jusii/ninepin-ux/hardware/rev7.1/fab/ninepin-ux-rev7.1-full-bom.csv

Comment | Designator | Footprint | LCSC Part #
22uF | C1 | C_0805_2012Metric | C45783
10uF | C2,C6,C10,C14 | C_0805_2012Metric | C15850
100nF | C3,C5,C7,C11,C12,C13,C23,C24,C26,C27,C28,C32,C36 | C_0603_1608Metric | C14663
150uF | C4 | CP_Elec_6.3x7.7 | C413656
1uF | C8,C9,C31 | C_0603_1608Metric | C15849
4.7uF | C20,C29,C38 | C_0402_1005Metric | C23733
100nF | C21,C22,C25,C30,C39,C40 | C_0402_1005Metric | C1525
15pF | C33,C34 | C_0603_1608Metric | C1644
4.7uF | C35 | C_0805_2012Metric | C1779
4.7uF | C37 | C_0603_1608Metric | C19666
SS34 | D1,D2,D3 | D_SMA | C8678
B5819W | D4,D5,D6 | D_SOD-123 | C8598
PESD5V0S1BA | D10,D11,D12,D20,D21,D22,D23,D24,D25,D26,D27,D28,D29,D30 | D_SOD-323 | C19224
PESD5V0S1BL | D13,D14,D15,D16,D17,D18,D19 | D_SOD-882 | C84374
750mA | F1 | Fuse_1812_4532Metric | C84140
500mA | F2,F3 | Fuse_1812_4532Metric | C17313
600R@100MHz | FB1 | L_0603_1608Metric | C19330
A500 KBD OUT | J1,J8 | PinHeader_1x08_P2.54mm_Vertical | C492407
SWD | J2 | PinHeader_1x03_P2.54mm_Vertical | C2937625
OLED | J3 | PinSocket_1x04_P2.54mm_Vertical | C2897367
USB-A HOST | J4 | USB_A_Molex_67643_Horizontal | C564920
ENCODER | J7 | PinHeader_2x03_P2.54mm_Vertical | C65114
KBD OUT (to Amiga) | J10,J12 | MiniDIN6_PS2_Socket_CUI_MD-60S | C6089346
USB-C | J13 | USB_C_Receptacle_GCT_USB4105-xx-A_16P_TopMnt_Horizontal | C5184243
3.3uH | L1 | L_2016_AOTA | C42411119
WS2812B-2020 | LED1 | LED_WS2812B-2020_PLCC4_2.0x2.0mm | C52917434
DE9 PORT 1 | P1,P2 | DSUB-9_Pins_Horizontal_P2.77x2.84mm_EdgePinOffset7.70mm_Housed_MountingHolesOffset9.12mm | C305939
2N7002 | Q1 | SOT-23 | C8545
BSS138 | Q2,Q3 | SOT-23 | C82045
4.7k | R41,R42,R68 | R_0603_1608Metric | C23162
5.1k | R43,R44 | R_0603_1608Metric | C23186
470 | R45,R55 | R_0603_1608Metric | C23179
100k | R46,R47 | R_0603_1608Metric | C25803
1k | R49,R52,R53,R54,R60 | R_0603_1608Metric | C21190
33 | R50,R59 | R_0603_1608Metric | C23140
10k | R56,R69 | R_0603_1608Metric | C25804
27 | R57,R58,R70,R71 | R_0603_1608Metric | C25190
10k | R61,R62,R63,R64,R65,R66,R67 | R_0402_1005Metric | C25744
15k | R72,R73 | R_0402_1005Metric | C25756
4x10k | RN1,RN2,RN4 | R_Array_Convex_4x0402 | C25725
4x10k | RN3 | R_Array_Convex_4x0603 | C29718
BOOT | SW1,SW2 | SW_Tactile_SPST_Angled_PTS645Vx58-2LFS | C285519
RP2350A | U1 | QFN-60-1EP_7x7mm_P0.4mm_EP3.4x3.4mm | C42411118
USBLC6-2SC6 | U2,U4 | SOT-23-6 | C7519
TLV75733PDRVR | U3 | WSON-6-1EP_2x2mm_P0.65mm_EP1x1.6mm | C2868428
SN74CBTD3861DBQR | U6,U7 | SSOP-24_3.9x8.7mm_P0.635mm | C44508
W25Q128JVSIQ | U8 | SOIC-8_5.3x5.3mm_P1.27mm | C97521
RM2 | U9 | RaspberryPi_RM2 | C49451547
TCA9554PWR | U10 | TSSOP-16_4.4x5mm_P0.65mm | C477924
TLV803SDBZR | U11 | SOT-23 | C132016
12MHz | Y1 | Crystal_SMD_3225-4Pin_3.2x2.5mm | C20625731
