jusii/ninepin-ux/hardware/case/ninepin-ux-case-tray.stl

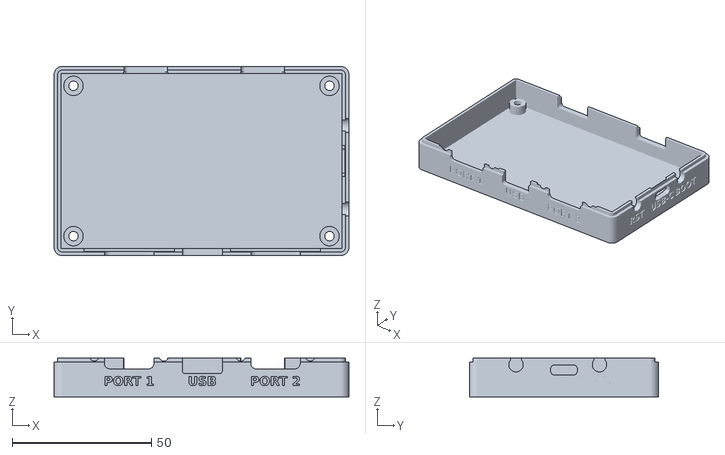
[picture p2: CAD file, 2026-11-13]
hardware/case/ninepin-ux-case-tray.stl
106.0 x 68.0 x 14.0
