jusii/ninepin-ux/hardware/case/ninepin-ux-case-tray-labels.stl

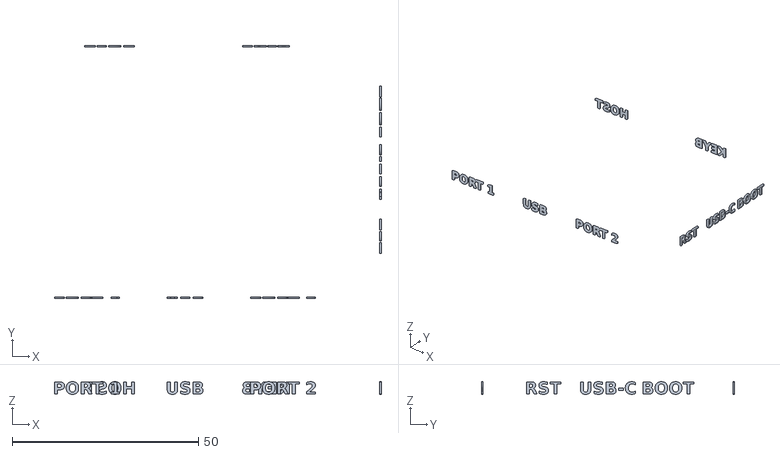
[picture p3: CAD file, 2026-11-13]
hardware/case/ninepin-ux-case-tray-labels.stl
87.7 x 68.0 x 3.41
