jusii/ninepin-ux/hardware/case/ninepin-ux-case.step

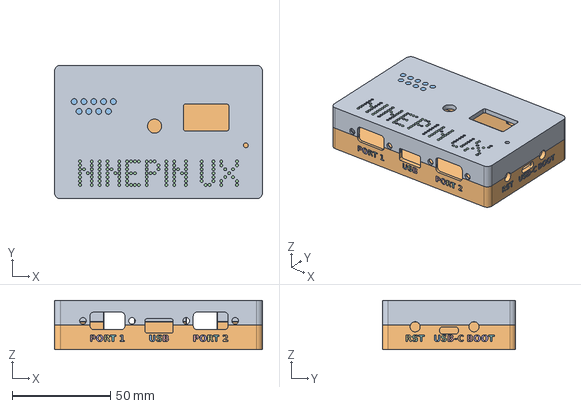
[picture p4: CAD file, 2026-11-13]
hardware/case/ninepin-ux-case.step
106.0 x 68.0 x 25.0 mm
