jusii/ninepin-ux/hardware/case/ninepin-ux-case-cap.stl

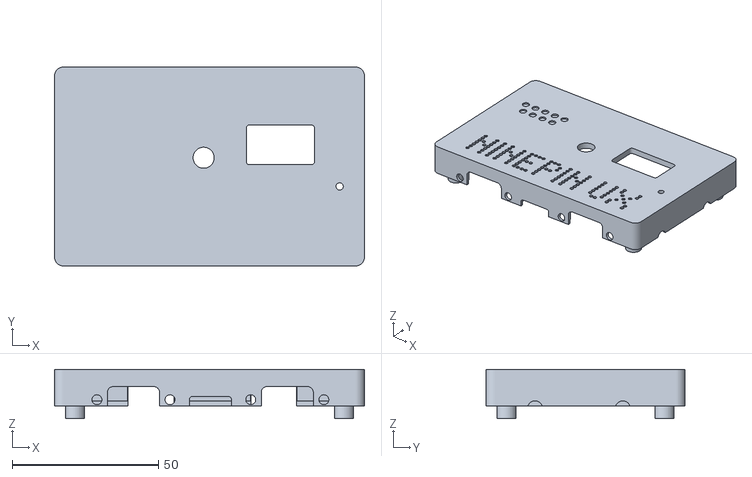
[picture p5: CAD file, 2026-11-13]
hardware/case/ninepin-ux-case-cap.stl
106.0 x 68.0 x 16.9
