jusii/ninepin-ux/hardware/case/ninepin-ux-case-cap-logo.stl

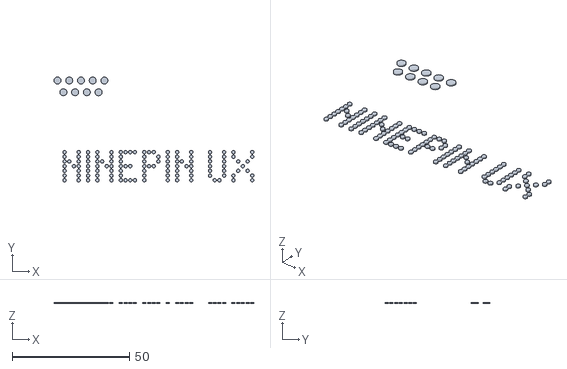
[picture p6: CAD file, 2026-11-13]
hardware/case/ninepin-ux-case-cap-logo.stl
85.2 x 44.7 x 0.6
