jusii/ninepin-ux/hardware/case/amigahid-pico-rev7-case.step

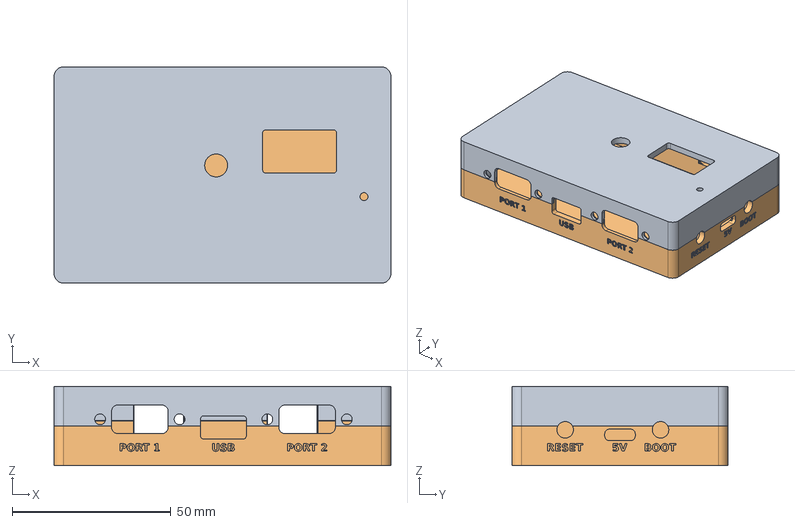
[picture p7: CAD file, 2026-11-10]
hardware/case/amigahid-pico-rev7-case.step
106.0 x 68.0 x 25.0 mm
