jusii/ninepin-ux/(list of files, cad)

Other CAD files:
hardware/case/ninepin-ux-case.FCStd
