jusii/ninepin-ux/hardware/rev7.1/ninepin-ux-rev7.1.kicad_pcb

## KiCad design hardware/rev7.1/ninepin-ux-rev7.1.kicad_pcb (2026-11-10)

Schematic: ninepin-ux-rev7.1.kicad_sch, Ninepin UX

Parts:
C1: 22uF; C_0805_2012Metric; LCSC C45783
C2, C6, C10, C14: 10uF; C_0805_2012Metric; LCSC C15850
C3, C5, C7, C11, C12, C13, C23, C24, C26, C27, C28, C32, C36: 100nF; C_0603_1608Metric; LCSC C14663
C4: 150uF; CP_Elec_6.3x7.7; MPN EEEFKC151XAP; LCSC C413656
C8, C9, C31: 1uF; C_0603_1608Metric; LCSC C15849
C20: 4.7uF; C_0402_1005Metric; LCSC C23733
C21, C22, C25, C30, C39, C40: 100nF; C_0402_1005Metric; LCSC C1525
C29, C38: 4.7uF; C_0402_1005Metric_vreg; LCSC C23733
C33, C34: 15pF; C_0603_1608Metric; LCSC C1644
C35: 4.7uF; C_0805_2012Metric; LCSC C1779
C37: 4.7uF; C_0603_1608Metric; LCSC C19666
D1, D2, D3: SS34; D_SMA; LCSC C8678
D4, D5, D6: B5819W; D_SOD-123; LCSC C8598
D10, D11, D12, D20, D21, D22, D23, D24, D25, D26, D27, D28, D29, D30: PESD5V0S1BA; D_SOD-323; LCSC C19224
D13, D14, D15, D16, D17, D18, D19: PESD5V0S1BL; D_SOD-882; MPN PESD5V0S1BL,315; LCSC C84374
F1: 750mA; Fuse_1812_4532Metric; MPN MF-MSMF075-2; LCSC C84140
F2, F3: 500mA; Fuse_1812_4532Metric; MPN MF-MSMF050-2; LCSC C17313
FB1: 600R@100MHz; L_0603_1608Metric; MPN BLM18AG601SN1D; LCSC C19330
J1: A500 KBD OUT; PinHeader_1x08_P2.54mm_Vertical; LCSC C492407
J2: SWD; PinHeader_1x03_P2.54mm_Vertical; LCSC C2937625
J3: OLED; PinSocket_1x04_P2.54mm_Vertical; MPN PM254-1-04-Z-8.5; LCSC C2897367
J4: USB-A HOST; USB_A_Molex_67643_Horizontal; MPN Molex 676432910; LCSC C564920
J7: ENCODER; PinHeader_2x03_P2.54mm_Vertical; MPN BOOMELE 2.54-2*3P; LCSC C65114
J8: A500 KBD IN; PinHeader_1x08_P2.54mm_Vertical; LCSC C492407
J10: KBD OUT (to Amiga); MiniDIN6_PS2_Socket_CUI_MD-60S; MPN CUI MD-60S; LCSC C6089346
J12: KBD IN (from keyboard); MiniDIN6_PS2_Socket_CUI_MD-60S; MPN CUI MD-60S; LCSC C6089346
J13: USB-C; USB_C_Receptacle_GCT_USB4105-xx-A_16P_TopMnt_Horizontal; MPN GCT USB4105-GF-A-120; LCSC C5184243
JP1: KBIN PWRLED; SolderJumper-2_P1.3mm_Open_RoundedPad1.0x1.5mm
L1: 3.3uH; L_2016_AOTA; MPN AOTA-B201610S3R3-101-T; LCSC C42411119
LED1: WS2812B-2020; LED_WS2812B-2020_PLCC4_2.0x2.0mm; LCSC C52917434
P1: DE9 PORT 1; DSUB-9_Pins_Horizontal_P2.77x2.84mm_EdgePinOffset7.70mm_Hou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; MPN TE 5747840-4; LCSC C305939
P2: DE9 PORT 2; DSUB-9_Pins_Horizontal_P2.77x2.84mm_EdgePinOffset7.70mm_Hou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; MPN TE 5747840-4; LCSC C305939
Q1: 2N7002; SOT-23; LCSC C8545
Q2, Q3: BSS138; SOT-23; LCSC C82045
R41, R42, R68: 4.7k; R_0603_1608Metric; LCSC C23162
R43, R44: 5.1k; R_0603_1608Metric; LCSC C23186
R45, R55: 470; R_0603_1608Metric; LCSC C23179
R46, R47: 100k; R_0603_1608Metric; LCSC C25803
R49, R52, R53, R54, R60: 1k; R_0603_1608Metric; LCSC C21190
R50, R59: 33; R_0603_1608Metric; LCSC C23140
R56, R69: 10k; R_0603_1608Metric; LCSC C25804
R57, R58, R70, R71: 27; R_0603_1608Metric; LCSC C25190
R61, R62, R63, R64, R65, R66, R67: 10k; R_0402_1005Metric; LCSC C25744
R72, R73: 15k; R_0402_1005Metric; LCSC C25756
RN1, RN2, RN4: 4x10k; R_Array_Convex_4x0402; LCSC C25725
RN3: 4x10k; R_Array_Convex_4x0603; LCSC C29718
SW1: BOOT; SW_Tactile_SPST_Angled_PTS645Vx58-2LFS; MPN C&K PTS645VK392LFS; LCSC C285519
SW2: RESET; SW_Tactile_SPST_Angled_PTS645Vx58-2LFS; MPN C&K PTS645VK392LFS; LCSC C285519
U1: RP2350A; QFN-60-1EP_7x7mm_P0.4mm_EP3.4x3.4mm; LCSC C42411118
U2, U4: USBLC6-2SC6; SOT-23-6; LCSC C7519
U3: TLV75733PDRVR; WSON-6-1EP_2x2mm_P0.65mm_EP1x1.6mm; LCSC C2868428
U6, U7: SN74CBTD3861DBQR; SSOP-24_3.9x8.7mm_P0.635mm; LCSC C44508
U8: W25Q128JVSIQ; SOIC-8_5.3x5.3mm_P1.27mm; LCSC C97521
U9: RM2; RaspberryPi_RM2; MPN Raspberry Pi RM2; LCSC C49451547
U10: TCA9554PWR; TSSOP-16_4.4x5mm_P0.65mm; LCSC C477924
U11: TLV803SDBZR; SOT-23; MPN TLV803SDBZR; LCSC C132016
Y1: 12MHz; Crystal_SMD_3225-4Pin_3.2x2.5mm; MPN ABM8-272-T3; LCSC C20625731

Connections:
/+3V3: C9.1, C10.1, C23.1, C24.1, C25.1, C26.1, C27.1, C28.1, C29.1, C30.1, C32.1, C39.1, C40.1, FB1.1, J3.2, J7.6, Q2.1 (G), Q3.1 (G), R41.1, R42.1, R50.1, R59.1, U1.1 (IOVDD), U1.11 (IOVDD), U1.20 (IOVDD), U1.30 (IOVDD), U1.38 (IOVDD), U1.45 (IOVDD), U1.49 (VREG_VIN), U1.53 (USB_OTP_VDD), U1.54 (QSPI_IOVDD), U3.1 (OUT), U8.8 (VCC), U10.16 (VDD), U11.3 (VCC)
/AMIGA_5V: D4.2 (A), F1.1, J1.4, J10.4
/AMIGA_5V_FUSED: D1.2 (A), F1.2, R60.1
/AMIGA_IO5V: C13.1, C14.1, D4.1 (K), D5.1 (K), D6.1 (K), R46.1, R61.2, R62.2, R63.2, R64.2, R65.2, R66.2, R67.2, RN1.5 (R4.2), RN1.6 (R3.2), RN1.7 (R2.2), RN1.8 (R1.2), RN2.5 (R4.2), RN2.6 (R3.2), RN2.7 (R2.2), RN2.8 (R1.2), RN3.5 (R4.2), RN3.6 (R3.2), RN3.7 (R2.2), RN3.8 (R1.2), U6.24 (VCC), U7.24 (VCC)
/AUX_5V: D2.2 (A), J13.A4 (VBUS), J13.A9 (VBUS), J13.B4 (VBUS), J13.B9 (VBUS), R68.1, U4.5 (VBUS)
/KBIN_5V: C6.1, C7.1, F3.2, J8.4, J12.4, RN4.5 (R4.2), RN4.6 (R3.2), RN4.7 (R2.2), RN4.8 (R1.2)
/LED_VDD: C12.1, D3.1 (K), LED1.4 (VDD), R49.1
/SYS5V: C1.1, C2.1, C3.1, C8.1, D1.1 (K), D2.1 (K), D3.2 (A), F2.1, F3.1, R45.2, U3.4 (EN), U3.6 (IN)
/USBA_5V: C4.1, C5.1, F2.2, J4.1 (VBUS), U2.5 (VBUS)
/adc_avdd: C31.1, R50.2, U1.44 (ADC_AVDD)
/amiga_sense: C11.1, R46.2, R47.1, U1.42 (GPIO28/ADC2)
/cont1_5v: D5.2 (A), P1.7
/cont1_b1: D16.1 (A1), P1.6, RN1.1 (R1.1), U6.8 (A7)
/cont1_b1_lo: U1.14 (GPIO10), U6.16 (B7)
/cont1_b2: D14.1 (A1), P1.9, RN1.3 (R3.1), U6.6 (A5)
/cont1_b2_lo: U1.12 (GPIO8), U6.18 (B5)
/cont1_b3: D13.1 (A1), P1.5, RN1.4 (R4.1), U6.5 (A4)
/cont1_b3_lo: U1.10 (GPIO7), U6.19 (B4)
/cont1_h: D17.1 (A1), P1.2, RN2.4 (R4.1), U6.9 (A8)
/cont1_h_lo: U1.15 (GPIO11), U6.15 (B8)
/cont1_hq: D19.1 (A1), P1.4, RN2.2 (R2.1), U6.11 (A10)
/cont1_hq_lo: U1.17 (GPIO13), U6.13 (B10)
/cont1_v: D15.1 (A1), P1.1, RN1.2 (R2.1), U6.7 (A6)
/cont1_v_lo: U1.13 (GPIO9), U6.17 (B6)
/cont1_vq: D18.1 (A1), P1.3, RN2.3 (R3.1), U6.10 (A9)
/cont1_vq_lo: U1.16 (GPIO12), U6.14 (B9)
/cont2_5v: D6.2 (A), P2.7
/cont2_b1: D23.1 (A1), P2.6, R62.1, U7.5 (A4)
/cont2_b1_lo: U1.28 (GPIO17), U7.19 (B4)
/cont2_b2: D27.1 (A1), P2.9, R66.1, U7.9 (A8)
/cont2_b2_lo: U1.33 (GPIO21), U7.15 (B8)
/cont2_b3: D28.1 (A1), P2.5, R67.1, U7.10 (A9)
/cont2_b3_lo: U1.34 (GPIO22), U7.14 (B9)
/cont2_h: D24.1 (A1), P2.2, R63.1, U7.6 (A5)
/cont2_h_lo: U1.29 (GPIO18), U7.18 (B5)
/cont2_hq: D26.1 (A1), P2.4, R65.1, U7.8 (A7)
/cont2_hq_lo: U1.32 (GPIO20), U7.16 (B7)
/cont2_v: D22.1 (A1), P2.1, R61.1, U7.4 (A3)
/cont2_v_lo: U1.27 (GPIO16), U7.20 (B3)
/cont2_vq: D25.1 (A1), P2.3, R64.1, U7.7 (A6)
/cont2_vq_lo: U1.31 (GPIO19), U7.17 (B6)
/dvdd: C20.1, C21.1, C22.1, C38.1, L1.1, U1.6 (DVDD), U1.23 (DVDD), U1.39 (DVDD), U1.50 (VREG_FB)
/enc_a: J7.5, U10.4 (P0)
/enc_b: J7.3, U10.5 (P1)
/enc_sp: J7.2, U10.7 (P3)
/enc_sw: J7.1, U10.6 (P2)
/exp_int: U1.5 (GPIO3), U10.13 (~INT)
/i2c_scl: J3.3, R42.2, U1.3 (GPIO1), U10.14 (SCL)
/i2c_sda: J3.4, R41.2, U1.2 (GPIO0), U10.15 (SDA)
/kb_drvled: D30.1 (A1), J1.8, J8.8
/kb_pwrled: D29.1 (A1), J1.7, J8.7, JP1.1 (A)
/kb_pwrled_bal: JP1.2 (B), R45.1
/kbclock: D12.1 (A1), J1.1, J10.5, RN3.3 (R3.1), U6.4 (A3)
/kbclock_lo: U1.9 (GPIO6), U6.20 (B3)
/kbdata: D11.1 (A1), J1.2, J10.1, RN3.2 (R2.1), U6.3 (A2)
/kbdata_lo: U1.8 (GPIO5), U6.21 (B2)
/kbin_clk: D20.1 (A1), J8.1, J12.5, Q3.3 (D), RN4.4 (R4.1)
/kbin_clk_lo: Q3.2 (S), U1.18 (GPIO14)
/kbin_dat: D21.1 (A1), J8.2, J12.1, Q2.3 (D), RN4.3 (R3.1)
/kbin_dat_lo: Q2.2 (S), U1.19 (GPIO15)
/kbreset: D10.1 (A1), J1.3, J8.3, U6.2 (A1)
/kbreset_lo: U1.7 (GPIO4), U6.22 (B1)
/pio_dm: R71.1, R73.1, U1.41 (GPIO27/ADC1)
/pio_dp: R70.1, R72.1, U1.40 (GPIO26/ADC0)
/qspi_sclk: U1.56 (QSPI_SCLK), U8.6 (CLK)
/qspi_sd0: U1.57 (QSPI_SD0), U8.5 (DI/IO_{0})
/qspi_sd1: U1.59 (QSPI_SD1), U8.2 (DO/IO_{1})
/qspi_sd2: U1.58 (QSPI_SD2), U8.3 (~WP/IO_{2})
/qspi_sd3: U1.55 (QSPI_SD3), U8.7 (~HOLD/~RESET/IO_{3})
/qspi_ss: R52.1, U1.60 (~QSPI_SS), U8.1 (~CS)
/qspi_ss_sw: R52.2, SW1.1
/run: R53.1, U1.26 (RUN)
/run_sw: R53.2, SW2.1, U11.2 (~RESET)
/swclk: J2.1, U1.24 (SWCLK)
/swdio: J2.3, U1.25 (SWDIO)
/usb_cc1: J13.A5 (CC1), R43.1
/usb_cc2: J13.B5 (CC2), R44.1
/usb_dm: R58.1, U1.51 (USB_DM)
/usb_dp: R57.1, U1.52 (USB_DP)
/usba_dm: J4.2 (D-), R71.2, U2.1 (I/O1), U2.6 (I/O1)
/usba_dp: J4.3 (D+), R70.2, U2.3 (I/O2), U2.4 (I/O2)
/usbc_dm: J13.A7 (D-), J13.B7 (D-), R58.2, U4.1 (I/O1), U4.6 (I/O1)
/usbc_dp: J13.A6 (D+), J13.B6 (D+), R57.2, U4.3 (I/O2), U4.4 (I/O2)
/vbus_sense: R68.2, R69.1, U10.9 (P4)
/vreg_avdd: C37.1, R59.2, U1.46 (VREG_AVDD)
/vreg_lx: L1.2, U1.48 (VREG_LX)
/wl_clk: U1.43 (GPIO29/ADC3), U9.3 (SCLK)
/wl_cs: U1.37 (GPIO25), U9.9 (CS)
/wl_d: R55.2, R56.2, U1.36 (GPIO24), U9.5 (DIN)
/wl_dout: R55.1, U9.6 (DOUT)
/wl_irq: R56.1, U9.10 (nIRQ)
/wl_on: U1.35 (GPIO23), U9.12 (WL_ON), U9.13 (BT_ON)
/wl_vin: C35.1, C36.1, FB1.2, U9.14 (VDDIO), U9.16 (VIN)
/ws_din: LED1.3 (DIN), Q1.3 (D), R49.2
/ws_drv: Q1.1 (G), U1.4 (GPIO2)
/xin: C33.1, U1.21 (XIN), Y1.1
/xout: R54.1, U1.22 (XOUT)
/xout_r: C34.1, R54.2, Y1.3
GND: C1.2, C2.2, C3.2, C4.2, C5.2, C6.2, C7.2, C8.2, C9.2, C10.2, C11.2, C12.2, C13.2, C14.2, C20.2, C21.2, C22.2, C23.2, C24.2, C25.2, C26.2, C27.2, C28.2, C29.2, C30.2, C31.2, C32.2, C33.2, C34.2, C35.2, C36.2, C37.2, C38.2, C39.2, C40.2, D10.2 (A2), D11.2 (A2), D12.2 (A2), D13.2 (A2), D14.2 (A2), D15.2 (A2), D16.2 (A2), D17.2 (A2), D18.2 (A2), D19.2 (A2), D20.2 (A2), D21.2 (A2), D22.2 (A2), D23.2 (A2), D24.2 (A2), D25.2 (A2), D26.2 (A2), D27.2 (A2), D28.2 (A2), D29.2 (A2), D30.2 (A2), J1.6, J2.2, J3.1, J4.4 (GND), J4.SH (Shield), J7.4, J8.6, J10.3, J10.SH (SHIELD), J12.3, J12.SH (SHIELD), J13.A1 (GND), J13.A12 (GND), J13.B1 (GND), J13.B12 (GND), J13.SH (SHIELD), LED1.2 (VSS), P1.8, P1.SH (PAD), P2.8, P2.SH (PAD), Q1.2 (S), R43.2, R44.2, R47.2, R60.2, R69.2, R72.2, R73.2, SW1.2, SW2.2, U1.47 (VREG_PGND), U1.61 (GND), U2.2 (GND), U3.3 (GND), U3.7 (GND), U4.2 (GND), U6.12 (GND), U6.23 (~OE), U7.12 (GND), U7.23 (~OE), U8.4 (GND), U9.1 (GND), U9.4 (GND), U9.7 (GND), U9.11 (GND), U9.15 (GND), U9.21 (GND), U10.1 (A0), U10.2 (A1), U10.3 (A2), U10.8 (GND), U11.1 (GND), Y1.2 (G), Y1.4 (G)

Notes on the sheet:
power tree
AMIGA_5V (keyboard connector / A500 header) -> F1 -> AMIGA_5V_FUSED -> D1 -> SYS5V; USB-C -> D2 -> SYS5V. Either source alone runs the board.
AMIGA_IO5V (2026-10-16) is the bus-switch / pull-up / Amiga-sense rail: OR-ed through D4 from AMIGA_5V (before F1, so the switches stay above their 4.5 V minimum; the rail draws ~20 mA and the DE9 legs are unfused anyway) and through D5 / D6 from DE9 pin 7 of each port, so the ports work with only 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
F1 750 mA fitted (rev6 bring-up measured the stack well under that). SYS5V -> U3 -> +3V3 (RP2350, RM2, flash, OLED, expander). R60 bleeds D1 leakage off the fused rail.
to amiga (keyboard out) / from real keyboard (keyboard in) / A500 headers
Mini-DIN6 uses the PS/2 pin positions: 1 KDAT, 3 GND, 4 +5 V, 5 KCLK. DIN5 Amigas use a passive adapter.
JP1 is for standalone use only (no Amiga on J1): bridges the A500 keyboard power LED through R45.
controller ports (DE9 male, straight-through F-F cables)
Pin 7 (+5 V) feeds only the I/O rail through D5 / D6: the ports power the bus switches and pull-ups, never the board itself.
level shifting: 2x SN74CBTD3861 bus switches, Amiga side on A, RP2350 side on B
VCC = AMIGA_IO5V (keyboard-connector 5 V or either DE9 pin 7, through D4-D6): the diode-dropped gate limits the B side to ~2.6-3.0 V typ (TI fig. 2) and the RP2350 internal pull-up completes the rise to 3.3 V. OE tied low (always on). VCC is one Schottky drop below the Amiga's 5 V (~4.5-4.8 V); D4 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
Keyboard-in (kbin_clk / kbin_dat) is not on U7 any more: Q2 / Q3 BSS138 shifters with RN4 on KBIN_5V and the RP2350 internal pull-ups on the GPIO side, so a real Amiga keyboard reads on USB-C power alone (device mode for a C64 Ultimate); U7 A1/A2 and B1/B2 are left open.
With the Amiga off the switches are open and the B side floats: firmware enables the RP2350 internal pull-ups on every _lo input.
Amiga-side pull-ups: 10k to AMIGA_IO5V - four 4-element arrays (RN1-RN3, RN4 on KBIN_5V) and seven 0402 resistors on the port-2 lines; kbreset has none. ESD clamps D10-D28 on every Amiga-facing line; the I/O rail itself takes an ESD hit on DE9 pin 7 into C14 (10 uF).
usb: USB-C on the RP2350 USB PHY (device, power, flashing), USB-A host on PIO-USB (GPIO26/27)
No mux (decided 2026-10-15): the native PHY serves USB-C, so the board can be a HID device for a USB host (Commodore 64 Ultimate) while USB-A stays a host on PIO-USB. USB-C is device-only: CC carries Rd and VBUS only flows in through D2 (review 2026-10-15).
USB-C is a UFP: 5.1k on each CC. VBUS -> AUX_5V -> D2 -> SYS5V. USB-A VBUS is SYS5V through F2.
mcu: RP2350A, 16 MB QSPI flash, 12 MHz crystal, BOOT / RESET, SWD
Per the RP2350 hardware design guide / Pico 2 W: VREG_VIN and VREG_AVDD on 3V3 (AVDD through 33R + 4.7uF), DVDD 4.7uF at pin 23 + 100nF at 6/39, 4.7uF CIN at VREG_VIN, 100nF per IOVDD pin, one 100nF shared by USB_OTP_VDD/QSPI_IOVDD.
BOOT pulls QSPI_SS low at reset (USB bootloader on USB-C); RESET pulls RUN low.
rev7.1: U11 (TLV803S, 2.93 V / 200 ms, open drain) also holds run_sw low until 3V3 is up and on brown-out.
radio: RM2 (CYW43439) on the Pico 2 W pin assignment
wl_d is the shared data line: DIN direct, DOUT through 470R, nIRQ through 10k, as on the Pico 2 W. WL_ON and BT_ON tied to GPIO23.
VIN and VDDIO from +3V3 through FB1. The module's own GPIO0-2 are unused.
display / status / spare
OLED posts H5-H8: copper passes 0.2 mm from the M2 holes under the post bases, so the posts, screws and nuts must be nylon (never metal hardware here).
J3 pin order is the common 0.96in SSD1306 module: GND VCC SCL SDA. LED1 is the only indicator: GPIO2 (output inverted in firmware) -> Q1 -> ws_din swings the full LED_VDD so the WS2812 VIH is met.

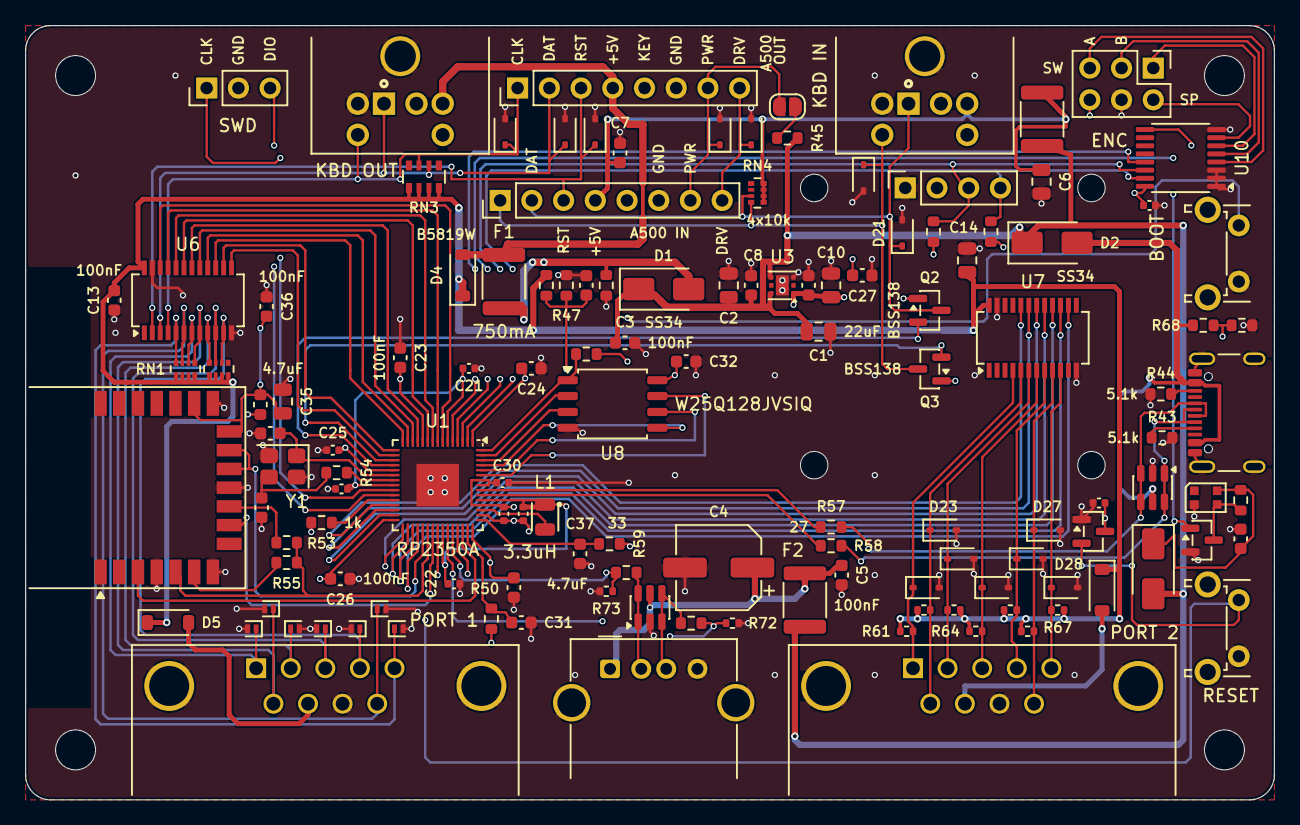
[picture p9: board ninepin-ux-rev7.1.kicad_pcb from above]

Board: 4 copper layers, 100.0 x 62.0 mm, 139 parts (0 on the bottom side), 99 nets.

Other parts of the board:
H1, H2, H3, H4: M3; MountingHole_3.2mm_M3
H5, H6, H7, H8: M2 OLED post; MountingHole_2.2mm_M2
