jusii/ninepin-ux/firmware/src/platform/amiga/keyboard_serial_io.c

/**
 * this file is part of amigahid-pico, (c) 2021 just nine <nine@aphlor.org>
 * please locate the full source at https://github.com/borb/amigahid-pico
 *
 * released under the terms of the Eclipse Public License 2.0 (EPL-2.0).
 * please find the complete license text at https://spdx.org/licenses/EPL-2.0
 *
 * amiga keyboard serial interface.
 */

#include "config.h"
#include "keyboard_serial_io.h"
#include "keyboard_map.h"
#include "keyboard.h"
#include "keyboard.pio.h" // generated at compile time
#include "usb_hid.h"
#include "util/output.h"
#include "util/debug_cons.h"
#include "util/status_led.h"

#include <stdint.h>
#include <stdbool.h>

#include "pico/stdlib.h"
#include "pico/util/queue.h"
#include "hardware/gpio.h"
#include "class/hid/hid.h"

enum _sync_state { IDLE, SYNC };
// don't optimise variables hit by the timer isr (timer callback?)
volatile enum _sync_state sync_state = IDLE;
volatile bool clock_timer_fired = false;

// caps lock will be read by the hid loop
bool caps_lock = false;
static bool ctrl = false;
static bool lamiga = false;
static bool ramiga = false;
static bool in_reset = false;
static bool local_reset_active = false;
static bool external_reset_active = false;
static bool reset_line_was_low = false;

// a real amiga keyboard tracks its own ctrl-lamiga-ramiga reset combo,
// independent of the usb/bt source, so the two cannot corrupt each other's
// modifier state at the merge point.
static bool rkb_ctrl = false;
static bool rkb_lamiga = false;
static bool rkb_ramiga = false;
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
