jusii/ninepin-ux/(commit log)

2026-08-04 platform: add REV6 board target with keyboard input pins
    REV6 keeps the REV4 pin map and adds a real Amiga keyboard input on
    gp14/15 and two status leds on gp16/17 (HAS_KBD_IN, HAS_STATUS_LEDS).
    PORT2_ROLE=KEYBOARD is rejected on REV6; on REV4 it sets HAS_KBD_IN.
    Drop the unused I2C_IRQN and INDICATOR_LED defines.
2026-08-04 platform/amiga: gate real keyboard input on HAS_KBD_IN
    The receive path was gated on PORT2_ROLE_KEYBOARD, which only describes
    how REV4 gets a keyboard input. keyboard_recv.c is now built
    unconditionally and stubs itself out on boards without one.
2026-08-04 build: infer rp2350 platform for pico2 boards
    PICO_PLATFORM now defaults from PICO_BOARD: pico2 and pico2_w select
    rp2350-arm-s, everything else rp2040. An explicit PICO_PLATFORM wins.
2026-08-04 platform/amiga: forward real keyboard kclk hold as reset
    A real Amiga keyboard requests a hard reset by holding KCLK low. After
    KBDIN_RESET_HOLD_MS (default 250ms) drive /rst and the outgoing clock
    low as ctrl-amiga-amiga does. The PIO receiver restarts on release; a
    line held low since boot is treated as unconnected.
    [keyboard_recv.c, keyboard_serial_io.c, keyboard_serial_io.h]
2026-08-04 util: add status led support
    rev6 leds on gpio 16/17: led 1 heartbeats until a usb or bluetooth
    device mounts, then stays solid; led 2 flashes per input event and
    blinks fast during a bluetooth pairing prompt. Boards without
    HAS_STATUS_LEDS get empty inline stubs.
2026-08-04 ci: add rev6 and keyboard-input build variants
    Adds rev4 with PORT2_ROLE=KEYBOARD, rev6 on pico, rev6 on pico w with
    bluetooth (plus an sh1106 variant) and rev6 on pico 2 w. Also runs on
    the working branches and on workflow_dispatch.
2026-08-04 platform/amiga: make keyboard reset survive its own reset
    Resync the receiver on any reset assertion once the wire is idle, which
    fixes a permanent one-bit frame offset. amiga_kbdin_restarted() drops
    stale modifiers so in_reset cannot latch. Hold detection ignores poll
    gaps over KBDIN_POLL_GAP_MAX_MS and gives up after _HOLD_MAX_MS.
    [keyboard_recv.c, keyboard_serial_io.c, keyboard_serial_io.h]
2026-08-04 util: correct the status led concurrency contract
    BTstack handlers run from an interrupt (threadsafe-background async
    context) and can preempt status_led_task(). Document that and mark the
    interrupt-written state volatile.
    [status_led.c, status_led.h]
2026-08-04 bluetooth: dismiss pairing prompts that never connect
    An auto-accepted SSP attempt that never opens L2CAP left the prompt on
    screen and the led 2 pairing blink latched. Clear it on simple pairing
    complete, authentication complete or disconnection.
2026-08-04 kicad: bootstrap rev6 project from rev5
    Copy the rev5 project to kicad/rev6/ and import the Raspberry Pi Pico W
    symbol and footprint into project-local rev6 libraries. The footprint
    has both castellated SMD and through-hole pads.
    [amigahid-pico-rev6.kicad_pcb, amigahid-pico-rev6.kicad_sch]
2026-08-04 tools: add rev6 netlist checker
    Cross-checks the rev6 netlist against the connectivity spec and the
    BOARD_HIDPICO_REV6 pin defines in src/config.h: gpio pads, level
    shifters, connector pinouts, power tree, protection, and a guard that
    the rev5 files are untouched.
2026-08-04 kicad: rev6 footprint library
    Pico W footprint with both castellated and through-hole pads, DIN5
    180deg socket (Kycon KCDX-5S-N) and mini-DIN6 socket (CUI MD-60S),
    drawn from manufacturer drawings.
2026-08-04 kicad: rev6 symbol library for the schematic
    PicoW gains TP2/TP3 USB test-point pins and an SH shell pin, and its
    power pin types are corrected so ERC sees the power tree. DIN5 and
    mini-DIN6 socket symbols add the shell terminal.
2026-08-04 kicad: rev6 schematic
    Fused, diode-ORed AMIGA_5V/USB-C power tree, 19 BSS138 level shifters,
    A500 header plus DIN5/mini-DIN6 keyboard in/out, two DE9 ports, USB-A
    host with USBLC6 and a TVS clamp on every Amiga-facing line. ERC clean,
    netlist checker passes.
    [amigahid-pico-rev6.kicad_sch]
2026-08-04 kicad: unmirror the DIN5 and mini-DIN6 land patterns
    Both footprints were drawn from bottom-view drawings without mirroring,
    which swapped +5V and GND on the keyboard sockets and would short the
    Amiga keyboard supply. The footprint descriptions record the check.
2026-08-04 kicad: add usb tap to pico w footprint, drop test pads
    TP2/TP3 (USB D-/D+) become 1.6/1.3 mm half vias bisected by a
    2.0 x 3.81 mm slot, as on rev5. Netless TP1/TP4/TP5/TP6 are removed.
    The tap only works with the module soldered flat.
2026-08-04 kicad: fix rev6 part numbers, packages and power tree
    Q1-Q19 now LCSC C78284 (BSS138), TVS on SOD-323, LED2 KT-0603YG. F3
    500 mA with local bulk, JP1 gains a 470R ballast, C4 220uF -> 150uF,
    C1/C4 polarised, D29/D30 clamp the led pass-throughs. Netlist checker
    re-targeted to 356 assertions.
    [amigahid-pico-rev6.kicad_sch]
2026-08-04 kicad: set jlcpcb fab rules and a power netclass for rev6
    Edge clearance 0.025 -> 0.3 mm, via 0.6 mm with 0.13 mm ring, clearance
    0.2 mm, hole and hole-to-hole 0.5 mm, silk 0.15 mm. Power netclass at
    1.0 mm for the 5 V rails and +3V3.
2026-08-04 kicad: rev6 board bootstrap - placement, outline, keepout
    100 x 80 mm, 2 layers, four M3 holes. Keyboard connectors north, DE9
    ports and USB-A south, Pico W west with an antenna rule area, USB-C
    east, level shifters and clamps on the bottom. No copper yet.
    [amigahid-pico-rev6.kicad_pcb]
2026-08-04 tools: add rev6 pcb checker
    Structural assertions DRC does not cover: outline, mounting holes,
    antenna keep-out, connector orientation, part sides, power track width,
    USB pair length, silkscreen, ground pours and the rev5 guard. Uses
    pcbnew bindings or falls back to parsing the board file.
2026-08-04 kicad: fix rev6 placement ahead of routing
    J4 was mounted back to front. U2 and F2 move topside, TP2/TP3 become
    castellated pads, the antenna rule area covers 11 x 15.8 mm, silk is
    trimmed inside the outline and edited footprints go into rev6.pretty.
    [amigahid-pico-rev6.kicad_pcb, amigahid-pico-rev6.kicad_sch]
2026-08-04 kicad: route rev6 board
    1524 track segments, 714 vias and GND pours on both layers. Power at
    1.0 mm, signals 0.25 mm, +3V3 0.5 mm. Pull-ups stand on end and shifter
    groups move to open routing lanes. USB pair hand-laid, 24.4/20.7 mm.
    [amigahid-pico-rev6.kicad_pcb]
2026-08-04 kicad: finish the rev6 copper
    Stitching grid 2.5 mm, tighter thermal relief, rail vias 0.6/0.3 mm.
    USB pair swaps sides on the back layer before J4 (24.7/22.8 mm). DRC
    still reports 2 starved thermals and 12 unconnected items.
    [amigahid-pico-rev6.kicad_pcb]
2026-08-05 tools: check every GND pad reaches the main ground island
    I5 unions GND pours, pads, tracks and vias into islands and asserts
    every GND pad is on the largest. It fails on the current board, naming
    the ground legs of D23, D25, D26 and D29.
2026-08-05 kicad: rf board keep-out, shifter designators, jlc silk
    Cut the board away under the antenna per the Pico W RF keep-out, widen
    the mini-DIN SH hole to 2.50 mm, show all bottom-side designators,
    raise silk strokes to 0.15 mm and add ground vias for five clamps.
    D23, D25, D26 and D29 grounds remain open.
    [amigahid-pico-rev6.kicad_pcb]
2026-08-05 kicad: thin the rev6 stitching via field
    1021 ground vias on a 2.5 mm grid blocked signal corridors at 0.5 mm
    hole clearance. Keep only vias carrying a stub plus island ties: 25.
    [amigahid-pico-rev6.kicad_pcb]
2026-08-05 kicad: move esd clamps to their pins and re-lay the copper
    Clamp rows follow connector pin order; worst stub 19.22 -> 7.05 mm. U2
    turned 180 deg so the USB pair no longer crosses (22.97/24.53 mm, no
    vias). Everything re-routed with via hole clearance enforced; ground
    is left out for now.
    [amigahid-pico-rev6.kicad_pcb]
2026-08-05 kicad: stitch the rev6 ground back in and finish the copper
    Ground stitched on an 8 mm grid, 114 vias. Module, J2, J4 and P1 shell
    ground pads use solid zone connections; routes ending in castellation
    pad corners are carried to the pad centre. /kbdata is still open and
    the D13/D15 grounds still sit on islands.
    [amigahid-pico-rev6.kicad_pcb]
2026-08-05 kicad: drop duplicated rev6 copper and trim dead stubs
    444 duplicate track and via objects removed, three dangling stubs
    trimmed to their last junction, P2 shell tabs solid-connected like P1.
    Ignore *.rpt. DRC 20 violations / 4 unconnected; /kbdata and the
    D13/D15 grounds remain open.
    [amigahid-pico-rev6.kicad_pcb]
2026-08-05 kicad: move esd clamps off the de9 pins and close /kbdata
    Clamp rows move 0.6 mm north (0.995 mm from the DE9 pads), every clamp
    gets its own ground via, the SYS5V rail is re-laid so /kbdata can cross
    and all ground islands are tied in. DRC 0 violations, 0 unconnected.
    [amigahid-pico-rev6.kicad_pcb]
2026-08-05 kicad: widen power vias and shorten decoupling returns
    Power layer transitions get 0.9/0.5 vias or up to three 0.6/0.3 vias in
    parallel. C2, C6 and C7 get a ground via within 0.7 mm. J4 centred
    between the DE9 hoods; J3 and J7 ground pins tied to the plane.
    [amigahid-pico-rev6.kicad_pcb]
2026-08-05 kicad: add a ground shadow under the usb pair
    Only 11-16% of usb_dp/usb_dm had ground on the opposite layer. A
    10.1 mm ground track follows the pair, stitched with 7 vias; coverage
    is now 51%/55%.
    [amigahid-pico-rev6.kicad_pcb]
2026-08-06 kicad: move the usb bulk cap topside
    C4 (150uF, 6.3 x 7.7 mm) was the only tall part on the bottom. It moves
    to the top east of the Pico, 10.29 mm from J4 pin 1; +3V3, cont2_hq_lo,
    cont2_vq_lo and usb_dp are re-laid around it.
    [amigahid-pico-rev6.kicad_pcb]
2026-08-06 tools: assert a low-profile bottom side
    E4 whitelists B.Cu packages (SOT-23, SOD-, 0603, 0805, LED_0603) and
    fails by refdes on anything else.
2026-08-06 tools: check usb bulk cap distance and rev6 project settings
    E5 measures C4 to J4 pin 1 (9.94 mm is the best reachable). J4/K1-K3
    assert the .kicad_pro is unmodified, meets the JLCPCB floors, keeps the
    Power netclass and has no DRC exclusions or downgraded rules.
2026-08-06 tools: add rev6 routing style checker
    S1: >=99% of track length on 45-degree multiples. S2: no staircases.
    S3: no slivers or duplicate copper. S4: worst nets by segment count
    (informational). Collinear segments are merged before measuring.
2026-08-06 kicad: re-lay the ground ties on 45-degree runs
    GND pad-to-via ties are re-laid between the same anchors as straight or
    orthogonal-plus-45 runs. 45-degree compliance 34.4% -> 35.8%.
    [amigahid-pico-rev6.kicad_pcb]
2026-08-06 kicad: pin real part numbers across the rev6 bom
    C1/C4 Panasonic FK cans (C128533/C413656), F1 C84140, F2/F3 C17313.
    Hand-soldered connectors, the Pico W and JP1 get a Sourcing field
    instead of an LCSC code. Fields only, mirrored into the pcb.
    [amigahid-pico-rev6.kicad_pcb, amigahid-pico-rev6.kicad_sch]
2026-08-06 kicad: void module test-pad copper and tidy the rev6 board
    An F.Cu rule area keeps copper off Pico W TP4-TP6 (TP6 low forces
    BOOTSEL). Also: 413 duplicate tracks removed, hand-soldered parts out of
    pos files, no paste on U1 shell pads, silk and designator fixes, and F1
    loses its LCSC code until it is sized.
    [amigahid-pico-rev6.kicad_pcb, amigahid-pico-rev6.kicad_sch]
2026-08-06 doc: add rev6 errata and the routing style gate
    Errata: test-pad copper void, plain Pico limits, F1 not to be ordered
    assembled, J4 overhang, unpowered DE9 ports, no RUN reset. Adds
    check_rev6_style.py to the board gates; ignore kicad lock, autosave,
    backup and report files.
2026-08-06 kicad: move the north connector labels inside their boxes
    J9-J12 designators now sit inside their own outlines, 0.90 mm from
    their pads.
    [amigahid-pico-rev6.kicad_pcb]
2026-08-07 kicad: re-lay the rev6 copper on 45-degree runs
    Every track re-laid on an octilinear grid along its existing topology.
    45-degree compliance 38.4% -> 99.5%, staircases 8 -> 0, five ground
    stitching vias added. USB dp 23.9 mm, skew 1.25 mm.
    [amigahid-pico-rev6.kicad_pcb]
2026-08-07 kicad: make the rev6 power netclass live
    net_settings.meta.version 2 made KiCad discard the netclass_patterns,
    so rails resolved to Default. Bump to 3, fix the 12 clearance errors
    this exposed, move +3V3 to Default, and make K2 ask pcbnew which
    netclass each rail resolves to.
    [amigahid-pico-rev6.kicad_pcb]
2026-08-26 kicad: credit r6 and link the fork on the silkscreen
    [amigahid-pico-rev6.kicad_pcb]
2026-08-26 doc: add the mouser bom next to the rev6 board files
    [rev6-mouser-bom.csv]
2026-08-26 kicad: rename the board to ux, drop the license line
    Silkscreen title "hid-pico Amiga UX", revision "UX rev 1". The license
    line is removed as no license file backs it; checker H2 re-targeted.
    P1/P2 sourcing fields get the measured DE9 dimensions.
    [amigahid-pico-rev6.kicad_pcb, amigahid-pico-rev6.kicad_sch]
2026-08-26 doc: fix first-power sequence and de9 sourcing
    F1 ships unfitted: bring-up starts at the current-limited USB-C aux
    input and F1 is sized from the measured draw. The DE9 BOM line pointed
    at a 9.4 mm family that does not fit. Gerber export rewrites the
    project file.
    [rev6-mouser-bom.csv]
2026-08-26 kicad: retarget the de9 land to the .318in family
    The old land matched only the obsolete Power Dynamics PDI-09S-5. P1/P2
    now use the .318in/8.08 mm family (Kycon K22X-E9P-N): boardlocks
    midway between pin rows, 1.1 mm pin drills, board 100 x 82.76 mm.
    The land is drawing-derived; verify against a physical connector.
    [amigahid-pico-rev6.kicad_pcb, amigahid-pico-rev6.kicad_sch]
2026-08-26 doc: point the de9 sourcing at kycon
    BOM and errata now name Kycon K22X-E9P-N and drop-in equivalents, and
    record the 100 x 82.76 mm board and the reduced USB-A overhang.
    [rev6-mouser-bom.csv]
2026-08-26 doc: use locale-prefixed mouser urls in the boms
    [rev6-mouser-bom.csv]
2026-08-26 doc: add a mouser bom-import cart csv
    [rev6-ux-mouser-cart.csv]
2026-08-26 doc: swap out-of-stock mouser parts, f1 low option msmf030
    msmf035 does not exist in the bourns line; the low f1 candidate is
    msmf030 (300 ma hold). caps to murata/kemet, ss34 to diodes inc
    b340a-13-f, esd clamps to bourns cdsod323-t05c, cc resistors to
    panasonic erj-3ekf5101v. cart part numbers carry the AmigahidUX mark.
    [amigahid-pico-rev6.kicad_pcb, amigahid-pico-rev6.kicad_sch, rev6-mouser-bom.csv, rev6-ux-mouser-cart.csv]
2026-08-26 doc: keep consumables out of the cart csv
    [rev6-ux-mouser-cart.csv]
2026-08-26 doc: cut the cart csv to exact one-unit quantities
    [rev6-ux-mouser-cart.csv]
2026-08-26 doc: swap the 10uf cap to the stocked tdk part
    C2/C6: tdk C2012X5R1V106K125AC replaces murata GRM21BR61E106KA73L.
    [rev6-ux-mouser-cart.csv]
2026-08-26 doc: record the 10uf cap as ordered
    C2/C6: tdk C2012X5R1V106K0C.
    [rev6-ux-mouser-cart.csv]
2026-08-26 kicad: freeze the ux rev 1 fab package
2026-09-27 kicad: mount the oled on a socket and two posts
    J3 becomes a 1x4 female socket in the module's pin order (GND VCC SCL
    SDA); M2 posts H1/H2 (2.2 mm NPTH) hold the east edge. i2c rerouted to
    the socket, swclk/swdio/cont1_b2_lo moved north of it, credit block to
    bottom silk. netlist checker J3 map re-targeted. posts 11 mm.
    [amigahid-pico-rev6.kicad_pcb, amigahid-pico-rev6.kicad_sch]
2026-09-27 tools: pin the netlist checker's oled-socket re-baseline
    check_rev6_pcb.py J3 points at the commit that re-targeted J3's pin map
    to the socket's order; the board gate is back to 38/38.
2026-09-27 kicad: keep the oled socket's silk at the 0.15 mm floor
    the stock PinSocket footprint draws its outline at 0.12 mm, below the
    jlcpcb silk floor; J3's six strokes go to 0.15 mm.
    [amigahid-pico-rev6.kicad_pcb]
2026-09-27 kicad: re-cut ux rev 1 fab package for oled socket, posts
    gerbers and drill regenerated with kicad-cli 10.0.6: 495 drill hits, 11
    tools, the two 2.2 mm M2 posts are the first NPTH entries.
    ORDER-CHECKLIST.md updated: outline, DE9 family, drill table, silk,
    USB-A overhang, OLED mount.
2026-09-28 doc: oled socket body 8.4 mm, posts stay 11 mm
    8.4 + 2.54 = 10.94 mm; the socket contacts take the rest.
2026-09-28 kicad: 1:1 fit-check template, bare-board step/stl
    fit-check-1to1.pdf: A4 landscape, board at 100% with every drilled hole
    at finished size, outline, top silk and a 50 mm scale bar. mech/:
    board-only STEP and STL for the case.
    [hid-pico-amiga-ux-rev1-board.step, hid-pico-amiga-ux-rev1-board.stl]
2026-09-28 kicad: 3d models for the din sockets, the oled and its posts
    kicad's library has no din5/mini-din6 socket or 0.96in oled module:
    dimensioned vrml blocks from the datasheets for kycon kcdx-5s-n, same
    sky md-60s, the module on 11 mm posts and the m2 posts. render-only.
    [amigahid-pico-rev6.kicad_pcb]
2026-09-28 kicad: step models for sockets and oled, assembly step/stl
    the vrml blocks become step (cadquery, same datasheet dimensions), so
    the step export carries every part. mech/ gains the full assembly
    step/stl: board, connectors, pico, oled on 11 mm posts and smds.
    [amigahid-pico-rev6.kicad_pcb, hid-pico-amiga-ux-rev1-assembly.step, hid-pico-amiga-ux-rev1-assembly.stl]
2026-10-12 build: update SDK and external dependencies
    Update Pico SDK to 2.3.1, TinyUSB to 0.21.0 and CYW43 to 2.0.0.
    Pin TinyUSB and CYW43 as upstream submodules and select them through
    the SDK's path overrides.
    Use the explicit USB host initialization API and document the
    independent dependency checkouts. Keep BTstack, lwIP and Mbed TLS at
    the SDK's release pins without dependency source patches.
2026-10-12 bluetooth: drop the removed report-with-fallback hid mode
    the pico-sdk 2.3.1 btstack drops
    HID_PROTOCOL_MODE_REPORT_WITH_FALLBACK_TO_BOOT. request REPORT: the
    device's actual mode arrives in the set-protocol response, which the
    connection table tracks and the boot-report parser honours.
2026-10-13 bom: cross-check the rev6 bom against the board
    every reference designator maps to one csv line and every purchasable
    line is in the cart. J3's female socket added to the cart, csv part
    numbers aligned with the cart, spares on hand-soldered small smds.
    [rev6-mouser-bom.csv, rev6-ux-mouser-cart.csv]
2026-10-13 doc: readme and ux rev 1 board guide
2026-10-13 doc: board photos
2026-10-13 doc: readme use case, a4000t on the din5 connector
2026-10-13 doc: trim errata, move design notes to kicad/rev6
2026-10-13 doc: add interactive bom
2026-10-13 bom: shorten descriptions
    [rev6-mouser-bom.csv]
2026-10-13 doc: rename to amigahid-pico-ux
2026-10-13 case: first enclosure, base plate and cap
    [amigahid-ux-case-base.stl, amigahid-ux-case-cap-print.stl, amigahid-ux-case-cap.stl, amigahid-ux-case.FCStd, amigahid-ux-case.step]
2026-10-13 case: oled recess, lower cap, labels by the openings
    [amigahid-ux-case-cap-print.stl, amigahid-ux-case-cap.stl, amigahid-ux-case.FCStd, amigahid-ux-case.step]
2026-10-13 case: flat lid, glass-sized window, taller oled mount
    [amigahid-ux-case-cap-print.stl, amigahid-ux-case-cap.stl, amigahid-ux-case.FCStd, amigahid-ux-case.step]
2026-10-14 case: lower de9 openings closed up, drop the west slot
    [amigahid-ux-case-cap-print.stl, amigahid-ux-case-cap.stl, amigahid-ux-case.FCStd, amigahid-ux-case.step]
2026-10-14 case: usb-a opening floor level with the de9s
    [amigahid-ux-case-cap-print.stl, amigahid-ux-case-cap.stl, amigahid-ux-case.FCStd, amigahid-ux-case.step]
2026-10-14 case: move the amiga label toward the gap
    [amigahid-ux-case-cap-print.stl, amigahid-ux-case-cap.stl, amigahid-ux-case.FCStd, amigahid-ux-case.step]
2026-10-14 case: centre the amiga label between the din5 openings
    [amigahid-ux-case-cap-print.stl, amigahid-ux-case-cap.stl, amigahid-ux-case.FCStd, amigahid-ux-case.step]
2026-10-14 case: rev 1 enclosure
    [amigahid-ux-case.FCStd]
2026-10-14 rev7: floorplan and rough case
    [amigahid-pico-rev7.kicad_pcb]
2026-10-14 rev7: thin the wall at the mini-DIN sockets
    [amigahid-pico-rev7.kicad_pcb]
2026-10-14 rev7: schematic generator and first full schematic
    [amigahid-pico-rev7.kicad_pcb, amigahid-pico-rev7.kicad_sch]
2026-10-14 rev7: netlist checker and BOM sourcing fields
    [amigahid-pico-rev7.kicad_sch]
2026-10-14 rev7: schematic fixes, firmware board target
    GPIO26/27 are not 5 V tolerant: moved to the LED driver and USB select.
    U3 to WSON-6 TLV75733PDRV, F1 fitted, R60 bleeder on the fused rail, L1
    polarity corrected. boards/amigahid_rev7.h and a WS2812 status LED
    driver.
    [amigahid-pico-rev7.kicad_sch]
2026-10-14 rev7: netlisted 4-layer board, placement
    [amigahid-pico-rev7.kicad_pcb]
2026-10-14 rev7: F1 fitted at 750 mA, SYS5V bulk 100 uF
    C1 drops from 220 uF to 100 uF to keep inrush through the Amiga
    polyswitch modest.
    [amigahid-pico-rev7.kicad_pcb, amigahid-pico-rev7.kicad_sch]
2026-10-14 rev7: board and style checkers, netclasses, parity fixes
    [amigahid-pico-rev7.kicad_pcb, amigahid-pico-rev7.kicad_sch]
2026-10-14 rev7: hide footprint data fields, silk fixes
    [amigahid-pico-rev7.kicad_pcb]
2026-10-14 rev7: routing phase 1, RP2350 core
    [amigahid-pico-rev7.kicad_pcb, amigahid-pico-rev7.kicad_sch]
2026-10-14 rev7: placement for the switch corridors, bus-switch pins
    [amigahid-pico-rev7.kicad_pcb, amigahid-pico-rev7.kicad_sch]
2026-10-14 rev7: routing phase 2a, keyboard switch
    [amigahid-pico-rev7.kicad_pcb]
2026-10-15 rev7: routing phase 2b, USB mux and port 2 band
    [amigahid-pico-rev7.kicad_pcb, amigahid-pico-rev7.kicad_sch]
2026-10-15 rev7: routing phase 2c, port 2 lines and USB corner
    [amigahid-pico-rev7.kicad_pcb]
2026-10-15 rev7: U6 to the west edge, port 1 and keyboard rerouted
    [amigahid-pico-rev7.kicad_pcb, amigahid-pico-rev7.kicad_sch]
2026-10-15 rev7: routing phase 3, north-east, port 2, east corner
    [amigahid-pico-rev7.kicad_pcb, amigahid-pico-rev7.kicad_sch]
2026-10-15 rev7: routing complete, all four gates green
    [amigahid-pico-rev7.kicad_pcb]
2026-10-15 rev7: widen the 5 V spine to 0.6 mm
    [amigahid-pico-rev7.kicad_pcb]
2026-10-15 rev7: board name on silk, 3D bodies for sockets, RM2, OLED
    3D bodies also for the fuses and the LED.
    [amigahid-pico-rev7.kicad_pcb]
2026-10-15 rev7: LCSC codes, THT parts assembled by JLCPCB
    [amigahid-pico-rev7.kicad_sch]
2026-10-15 rev7: via placement, KBIN neck, RM2 grounds, LDO vias
    more ground stitching. port 1 clamps become the bidirectional
    PESD5V0S1BL so a reversed placement cannot pin the line low.
    [amigahid-pico-rev7.kicad_pcb, amigahid-pico-rev7.kicad_sch]
2026-10-15 rev7: drop the USB mux, add I2C expander and encoder header
    USB-C stays on the RP2350 PHY; USB-A becomes a PIO-USB host on
    GPIO26/27 with 27R series resistors. GPIO2 drives the status LED and
    GPIO3 takes the expander interrupt; the UART header becomes the J7
    encoder header. Core regulator parts grouped at the pins.
    [amigahid-pico-rev7.kicad_pcb, amigahid-pico-rev7.kicad_sch]
2026-10-16 rev7: TCA9554 expander, VBUS divider, USB-C device-only
    The TCA9554 has internal pull-ups on its P ports, so the encoder lines
    and unused inputs never float. VBUS sense through a 6.8k/10k divider
    to P4. USB-C CC carries Rd only and VBUS only flows in through D2.
    [amigahid-pico-rev7.kicad_pcb, amigahid-pico-rev7.kicad_sch]
2026-10-16 rev7: core regulator laid out per datasheet fig. 26
    COUT (C38) is a 0402 straddling VOUT and PGND with LX between its
    pads; new footprints C_0402_1005Metric_vreg and L_2016_AOTA. The
    port-2 band jogs under the group; vias moved out of pads.
    [amigahid-pico-rev7.kicad_pcb, amigahid-pico-rev7.kicad_sch]
2026-10-16 rev7: core regulator layout refinements
    In1 cut out under the LX pad, direct COUT connection, AVDD row moved
    lower, a layer hop moved off the routing lanes.
    [amigahid-pico-rev7.kicad_pcb]
2026-10-16 rev7: Amiga I/O rail OR-ed from keyboard and DE9 ports
    AMIGA_IO5V feeds the bus switches, pull-ups and Amiga sense through
    B5819W diodes D4-D6 from the keyboard 5 V and DE9 pin 7 of each port.
    Keyboard-in moves to BSS138 shifters Q2/Q3 and works on USB-C power.
    L1 becomes MTQH201612S3R3MBT; VBUS divider changed to 4.7k/10k.
    [amigahid-pico-rev7.kicad_pcb, amigahid-pico-rev7.kicad_sch]
2026-10-16 rev7: DE9 5 V nets in Power class, label and via fixes
    Labels moved to their headers, a parallel via on a supply connection,
    and the DE9 pin 7 nets assigned to the Power netclass.
    [amigahid-pico-rev7.kicad_pcb]
2026-10-16 rev7: I/O rail before the fuse, USB host pull-downs
    D4 takes AMIGA_5V before F1 so the bus switches stay above 4.5 V.
    kbreset loses its board pull-up (the A500 pulls it up itself). 15k
    pull-downs on the PIO-USB pair against RP2350-E9, 10 uF bulk (C14) on
    the I/O rail, vias kept off pad edges.
    [amigahid-pico-rev7.kicad_pcb, amigahid-pico-rev7.kicad_sch]
2026-10-17 rev7 firmware: pin map for the mux-less USB layout
    LED on GPIO2, expander interrupt on GPIO3, PIO-USB on GPIO26/27, I2C0;
    the USB mux select and the UART are gone.
2026-10-17 rev7 fab: JLCPCB order package generated by make_fab.py
    Gerbers, BOM, CPL, manifest and order checklist.
    [amigahid-pico-rev7-bom.csv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]
2026-10-17 rev7 fab: one BOM line per LCSC part
    JLCPCB rejects duplicate part matches. Also adds lib/pico_pio_usb as
    a submodule.
    [amigahid-pico-rev7-bom.csv]
2026-10-17 rev7 fab: CPL in the gerber frame, Y negated
    JLCPCB overlays the CPL on the gerbers in that frame.
    [amigahid-pico-rev7-cpl.csv]
2026-10-17 rev7 firmware: USB-A host, USB-C device, expander, run modes
    PIO-USB host on the USB-A port; the native PHY is a USB-C device with
    a VBUS-gated pull-up. TCA9554 expander driver, Amiga-on sense, boot
    button and run modes; CI builds the rev7 target.
2026-10-17 rev7 fab: headers rotated to JLCPCB's convention in the CPL
    [amigahid-pico-rev7-cpl.csv]
2026-10-17 rev7 fab: CPL positions at the pad centre
    JLCPCB places parts by their pad centre, not the footprint origin.
    [amigahid-pico-rev7-cpl.csv]
2026-10-17 rev7: distributor BOM priced at Mouser and Digi-Key
    [rev7-digikey-bom-10.csv, rev7-digikey-bom-2.csv, rev7-mouser-bom-10.csv, rev7-mouser-bom-2.csv]
2026-10-17 rev7 bom: order quantities raised to the cheaper price break
    [rev7-digikey-bom-10.csv, rev7-digikey-bom-2.csv, rev7-mouser-bom-10.csv, rev7-mouser-bom-2.csv]
2026-10-17 rev7 bom: single-board import files with exact counts
    [rev7-digikey-bom-1.csv, rev7-mouser-bom-1.csv]
2026-10-18 rev7: OLED posts moved to the 26 mm module
    OLED module pcb 26.0 x 26.0 mm, holes 22.2 x 22.2 on 1.9 mm insets;
    J3 stays put. Case ceiling 16.0 mm above the board underside. C6, C7
    and D20 re-placed; no-connect nets assigned on the pads.
    [amigahid-pico-rev7.kicad_pcb]
2026-10-18 rev7 fab: package re-cut for the moved OLED posts
    [amigahid-pico-rev7-cpl.csv]
2026-10-18 rev7 fab: checklist notes the measured OLED and the re-cut
2026-10-18 rev7 case: enclosure with encoder on the lid, STL/STEP
    Generated from the floorplan and the board, with a fit check against
    the board parts. Outer 106 x 68 x 25 mm (cap 22.5 + base 2.5).
    [amigahid-pico-rev7-base.stl, amigahid-pico-rev7-cap.stl, amigahid-pico-rev7-case.FCStd, amigahid-pico-rev7-case.step]
2026-10-18 rev7 case: ignore FreeCAD backups
2026-10-18 rev7 case: wall labels below the openings
    [amigahid-pico-rev7-cap.stl, amigahid-pico-rev7-case.FCStd, amigahid-pico-rev7-case.step]
2026-10-18 rev7 silk: part labels, header pin names, back description
    silk_labels.py places reference and value beside every part with
    room, pin names on the headers and a description block on the back.
    [amigahid-pico-rev7.kicad_pcb]
2026-10-18 rev7 fab: package re-cut with the labelled silk
    The JLCPCB order number anchor text is gone; the checklist selects
    the order number removal option instead.
2026-10-18 rev7 silk: C64 joystick ports on the back
    [amigahid-pico-rev7.kicad_pcb]
2026-10-18 rev7 fab: package re-cut (back silk)
2026-10-27 rev7 bom: re-priced, VK58 switches, 16 V fallback for C1
    PTS645VK58 switches match the case (JLC's VK39 is 2 mm shorter).
    Adds 3-board import files and a partial-assembly recipe to the
    checklist: JLCPCB places U1, U3 and D13-D19, the rest from Mouser.
    [rev7-digikey-bom-1.csv, rev7-digikey-bom-10.csv, rev7-digikey-bom-2.csv, rev7-digikey-bom-3.csv, rev7-mouser-bom-1.csv, rev7-mouser-bom-10.csv, rev7-mouser-bom-2.csv, rev7-mouser-bom-3.csv]
2026-10-27 rev7 bom: project name first in the customer reference
    [rev7-digikey-bom-1.csv, rev7-digikey-bom-10.csv, rev7-digikey-bom-2.csv, rev7-digikey-bom-3.csv, rev7-mouser-bom-1.csv, rev7-mouser-bom-10.csv, rev7-mouser-bom-2.csv, rev7-mouser-bom-3.csv]
2026-11-08 rev7 firmware: keep the status led off the pio-usb pio
    The led took pio2 sm0 first (the free-sm search runs from the top),
    so pio-usb panicked in pio_sm_claim() inside tusb_init() and the
    usb-c port never came up. The led now claims from pio0 upward and
    skips PIO_USB_PIO.
    [config.h, status_led.c]
2026-11-08 display: ignore late i2c interrupts from a borrowed bus
    A late stop_det after disp_i2c_bus_release() ran the isr with no
    transaction and freed a null pointer, a bus fault in the i2c0 irq.
    Release now waits up to 200 us for the controller to go idle; the isr
    returns when nothing of its own is in flight.
2026-11-08 rev7 firmware: retry expander init, usb-c state on oled
    A single failed io_expander_init() left vbus unread and the usb-c
    port down for good; it is now retried every 500 ms while the bus is
    free. Oled line 1 shows "usb-c:<state> try:<n>".
    [debug_cons.c, debug_cons.h, io_expander.c, io_expander.h, main.c]
2026-11-08 firmware: AHP_BRINGUP option for board bring-up
    -DAHP_BRINGUP=ON (default off): usb device stack served from a 1 ms
    timer irq from the top of main(), boot breadcrumbs on oled and
    console, a ram hard-fault handler logging to watchdog scratch and a
    300 ms watchdog. Compiles away in a normal build.
2026-11-08 rev7 firmware: real amiga keyboard on usb-c in usb-dev mode
    Keys go through an amiga -> hid keymap into a new input slot merged
    into the boot keyboard. Held keys are tracked per side, caps lock
    follows the keyboard lamp, and ctrl-amiga-amiga does not reset the
    amiga in usb-dev mode.
    [bt_hid.c, input_bridge_bt.h, keyboard_recv.c, keyboard_recv.h, run_mode.c]
2026-11-08 usb device: reboot into BOOTSEL on a 1200 baud touch
    Setting the cdc console to 1200 baud reboots into the bootrom's usb
    boot mode after 20 ms, so firmware can be copied without holding
    BOOT. Needs running firmware.
2026-11-08 rev7 build: A/B partition table for over-the-air updates
    16M flash: slot A at 8K-4M, slot B at 4M to 12K short of 8M; the top
    20K stays unpartitioned for settings, btstack and the E10 sector. The
    build writes partition-table.uf2 and fails if the image outgrows the
    4084K slot.
2026-11-08 firmware: persistent settings and console commands
    Two alternating flash sectors with sequence number and crc32, ported
    from stefan reinauer's settings.c (EPL-2.0). The usb-c console takes
    help, info, settings, mode, defaults, reboot and bootsel; the run
    mode is stored and restored at boot.
    [console_cmd.c, console_cmd.h, main.c, run_mode.c, run_mode.h, settings.c, settings.h]
2026-11-08 rev7 firmware: settings menu on the oled
    One setting at a time, edited on a copy and stored by save & exit.
    Driven from keyboards (hold help 1 s), the BOOT button, the encoder
    or console menu commands. While open the menu owns the display and
    the inputs.
2026-11-08 firmware: keyboard settings and remaps in both directions
    usb/bt keyboard -> amiga: eight remap slots, help/del/iso key choices
    and letter presets (keyboard_map.c from stefan reinauer, EPL-2.0).
    amiga keyboard -> usb: eight remap slots, numpad paren styles and an
    optional ctrl-alt-del on ctrl-amiga-amiga. Slots taught from the menu.
2026-11-08 firmware: usb pads and the player manager
    Pads decode into one normalised record (pad.h); pads.c assigns
    players by connection order and maps d-pad, stick and buttons per the
    settings. The usb host takes dualsense (ds5.c), ps3 and generic hid
    pads (hid_gamepad.c from stefan reinauer).
2026-11-08 rev7 firmware: try-before-you-buy updates into the a/b slots
    Images are TBYB: a flash update boot runs on trial and ota.c accepts
    after 10 s of clean main loop, else the previous firmware boots. The
    settings page streams uploads into the free slot; menu and console
    can boot the previous firmware.
2026-11-09 keyboard: pass long reset holds through from real keyboard
    The kclk hold was cut at 3 s; it now lasts as long as the keyboard
    holds it, up to 30 s, so expansions acting on a long reset work. The
    console logs how long each amiga reset was held.
    [keyboard_recv.c, keyboard_serial_io.c]
2026-11-09 ota: uploads no longer starve the radio of receive buffers
    Holding lwip pbufs as back-pressure drained the pool the cyw43 driver
    receives into, and uploads stalled. Chunks are now copied out at once
    and flow control uses the tcp window; the ring is 32K, writes go per
    4K sector and the pbuf pool is 32.
    [http_server.c, lwipopts.h, ota.c]
2026-11-09 ota: uploads over wi-fi complete with bluetooth on
    Bluetooth inquiry and le scanning hold the shared radio and wi-fi
    frames get lost. Scanning pauses during uploads, flash writes happen
    only with the tcp window shut, the stall check is signed, and station
    mode runs without power save.
    [bt_hid.c, bt_hid.h, http_server.c, ota.c, ota.h, wifi.c]
2026-11-09 menu: enter no longer changes a setting
    Enter on a choice stepped to the next value; it now leaves the value
    alone and left/right change it. The BOOT button keeps "next value"
    on a 1 s hold through MENU_IN_CYCLE.
    [menu.c, menu.h]
2026-11-09 tools: rev7 bench readme runs the scripts through bash
    For checkouts on a noexec mount.
2026-11-09 rev6: drop ordering notes and the 23 MB assembly stl
    The Mouser BOM csv, gerbers and fit-check stay; the assembly STEP holds
    the same model as the dropped STL.
    [hid-pico-amiga-ux-rev1-assembly.stl, rev6-ux-mouser-cart.csv]
2026-11-09 rev7: drop design notes, priced bom tables and bench extras
    Kept: KiCad sources, generators, checkers, fab outputs, one-board
    Mouser/Digi-Key import files, case. con.sh writes to a temp file.
    [rev7-digikey-bom-10.csv, rev7-digikey-bom-2.csv, rev7-digikey-bom-3.csv, rev7-mouser-bom-10.csv, rev7-mouser-bom-2.csv, rev7-mouser-bom-3.csv]
2026-11-09 doc: rev7 readme, board guide, errata, parts notes
    README lists the rev7 features. errata: 1 uF + 820k across SW2 for cold
    boot, LED1 sourcing, OLED dimensions. bom/README covers parts the
    distributors don't stock. Adds the rev7 interactive BOM.
2026-11-09 ci: build board-rev7 pushes
2026-11-09 keyboard: wait for the amiga's handshake after each key code
    The amiga acknowledges a code by holding KDAT low for at least 85 us;
    a code sent before that is lost. Wait for the ack (a low of 40 us or
    more after release, up to the 143 ms a real keyboard waits) instead of
    a fixed 5 ms. Unacknowledged codes are counted (console info).
    [console_cmd.c, keyboard_serial_io.c, keyboard_serial_io.h]
2026-11-09 network control: kvmd-compatible keyboard and mouse api
    A subset of the PiKVM kvmd HTTP API under /api/, so PiKVM and GL.iNet
    KVM clients and their MCP servers drive the machine behind the board:
    auth (X-KVMD headers, basic, auth_token cookie), info, hid state,
    keymaps, print (en-us en-gb fi sv de fr), send_key, send_shortcut and
    the mouse calls. Input joins the other sources and follows the mode.
    Off by default ("Network control"), refused in access point mode, 30 s
    lockout after 5 wrong passwords, held input released after 60 s idle.
    Output is paced: one keyboard change per delivered report, 30 ms per
    character to the amiga, 50 ms per mouse button change. USB-C gains an
    absolute pointer;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
    [debug_cons.c, debug_cons.h, http_server.c, input_bridge_bt.h, kvmd_api.c, kvmd_api.h, kvmd_keys.c, kvmd_keys.h]
2026-11-09 rev7 case: clamshell split so the board fits
    Connectors stick out on three sides (DE9 and USB-A south, buttons and
    USB-C east, mini-DIN north), so a one-piece cap could not go on. The
    case now splits at 6.0 mm above the board underside: the tray holds
    the plate, standoffs and walls with upward-open notches, the cap the
    walls above, the lid and the pillars. A 1.5 mm lip on the tray's inner
    wall locates the cap, notched where parts pass it. Neither half needs
    supports. The generator checks the assembly: the board swept down into
    the tray and the cap swept down over it must not touch either half.
    [amigahid-pico-rev7-base.stl, amigahid-pico-rev7-cap.stl, amigahid-pico-rev7-case.FCStd, amigahid-pico-rev7-case.step, amigahid-pico-rev7-tray.stl]
2026-11-09 keyboard: fall back to a fixed wait where no ack is ever seen
    After 3 key codes in a row without the amiga's ack (a board that cannot
    read KDAT back), wait 5 ms instead of 143 ms, still watching for an ack.
    AKB_WAIT_HANDSHAKE=0 builds the old fixed 5 ms for comparison; the
    network pacing values can be overridden at build time.
    [keyboard_serial_io.c, kvmd_api.c]
2026-11-09 rev7.1: rev7 plus a RUN reset supervisor
    U11 TLV803S (2.93 V, 200 ms, open drain) holds RUN low until 3V3 is up
    and again on a brown-out, which fixes the rev7 cold-plug BOOTSEL bug.
    C40 decouples it. It sits in the free pocket south of the OLED; the
    output reaches SW2 pad 1 through a via south of the USB-C pair and B.Cu
    under the AMIGA_IO5V column. route.py block 5 is the only new copper:
    the generators reproduce the rev7 board track for track.
    R70/R71 move to C25190 (one BOM line fewer) and L1 back to the Abracon
    AOTA the land was drawn for. make_fab.py gets the JLC rotation offsets
    read from the rev7 placement preview and the SMT-only recipe (THT parts,
    L1 and LED1 hand-fitted; Mouser BOM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
    [amigahid-pico-rev7.1.kicad_pcb, amigahid-pico-rev7.1.kicad_sch, rev7.1-mouser-hand-10.csv]
2026-11-09 rev7.1 fab: package for the SMT-only Economic order
    Gerbers, BOM (41 lines) and CPL (116 placements) cut from 6a102e0 with
    a clean tree. THT parts, L1 and LED1 are left out for hand fitting.
    Rotation offsets for SSOP-24, SOIC-8, SOT-23-6 and SOT-23 are applied;
    confirm them in the JLC placement preview before ordering.
    [amigahid-pico-rev7.1-bom.csv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]
2026-11-10 rev7 case: centre the BOOT/RESET holes on the actuators
    The holes, lip notches and labels were placed at SW_Y, the switch
    footprint origin, which is pin 1. The PTS645Vx58 actuator sits half-way
    between pins 1 and 2, 2.25 mm further south, so both holes were 2.25 mm
    off on the printed case. USB-C was fine because its footprint origin is
    the connector centre. The board is unchanged; rev7.1 uses the same case.
    [amigahid-pico-rev7-cap.stl, amigahid-pico-rev7-case.FCStd, amigahid-pico-rev7-case.step, amigahid-pico-rev7-tray.stl]
2026-11-10 restructure: firmware/, hardware/rev7.1, hardware/case; old boards to tags
    The tree now holds the current board only:
    - firmware/: src, boards, CMakeLists.txt and the four submodules
    (pico-sdk, lib/tinyusb, lib/cyw43-driver, lib/pico_pio_usb)
    - hardware/rev7.1/: the rev7.1 KiCad project, generators, fab and bom
    - hardware/case/: the clamshell case, now built against rev7.1
    - tools/: the rev7.1 checkers and the bench scripts
    The upstream rev2-5 board (kicad/amigahid-pico.*), UX rev 1 (kicad/rev6)
    and UX rev7 (kicad/rev7) leave the tree. They stay byte-identical in the
    annotated tags hw/upstream-rev5, hw/ux-rev1 and hw/ux-rev7 on 287d909.
    Their checkers go with them.
    check_rev7_1_netlist s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
    [amigahid-pico-rev6.kicad_pcb, amigahid-pico-rev6.kicad_sch, amigahid-pico-rev7-bom.csv, amigahid-pico-rev7-cap.stl, amigahid-pico-rev7-case.FCStd, amigahid-pico-rev7-case.step, amigahid-pico-rev7-tray.stl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]
2026-11-10 firmware: rev7 only
    Drop the rev2, rev4 and rev6 board blocks, the plain Pico / Pico W /
    Pico 2 W build paths and PORT2_ROLE. BOARD_TYPE now defaults to
    BOARD_HIDPICO_REV7 (rev7 and rev7.1 share the pin map and the image)
    and Bluetooth defaults on.
    The capability flags rev7 always sets (HAS_USB_DEVICE, HAS_PIO_USB_HOST,
    HAS_KBD_IN, HAS_DE9_OUTPUTS, HAS_OTA, HAS_MENU, ...) are resolved with
    unifdef, together with the stubs and fallbacks only the older boards
    used. HAS_WIFI stays: it follows ENABLE_BLUETOOTH_HID.
    The rev7 images are unchanged but for the empty board_pins_usb_host()
    and its call: every other function and data symbol has the same size in
    both the Bluetooth and the no-Bluetooth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
    [amiga_sense.c, amiga_sense.h, board_pins.c, board_pins.h, cd32.c, cd32.h, config.h, console_cmd.c]
2026-11-10 firmware: Ninepin UX names
    What a user sees now says Ninepin:
    - USB manufacturer "Ninepin", product "Ninepin UX", interfaces
    "Ninepin keyboard", "Ninepin mouse", "Ninepin gamepad 1/2",
    "Ninepin pointer", "Ninepin debug console"
    - Wi-Fi access point and mDNS host ninepin-xxxx
    - Bluetooth local name "Ninepin UX"
    - kvmd api version and platform "ninepin-ux"
    - console banner with github.com/jusii/ninepin-ux and the upstream credit
    - build output ninepin-ux.uf2 (CMake project and target ninepin-ux)
    BOARD_HIDPICO_REV7, the ahp_ prefixes, boards/amigahid_rev7.h and the
    EPL file headers keep their names.
    Bench: con.sh and flash.sh find the console by either name while boards
    still run older fi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
2026-11-10 rev7.1: Ninepin UX name on the board and in the files
    Silkscreen only; no copper, footprint or label moves (checked item by
    item against the previous board, and zone fill areas per layer):
    - back block, from y 20: "Ninepin UX rev7.1 2026-11", "USB and
    Bluetooth HID bridge for retro computers", the two feature lines,
    github.com/jusii/ninepin-ux and "based on github.com/borb/amigahid-pico"
    - the Dwgs.User title below the outline: "Ninepin UX rev7.1"
    - schematic title block: "Ninepin UX", new repository in comment 2
    The KiCad project, the generators and the fab outputs are renamed
    amigahid-pico-rev7.1.* -> ninepin-ux-rev7.1.*; .kicad_pro/.kicad_prl
    differ from before in the file names on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
    [ninepin-ux-rev7.1-bom.csv, ninepin-ux-rev7.1.kicad_pcb, ninepin-ux-rev7.1.kicad_sch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]
2026-11-10 case: build against rev7.1, Ninepin UX file names
    run_case.py, export_parts.py and enclosure.py read the board, the
    floorplan and the package heights from hardware/rev7.1 and
    tools/check_rev7_1_pcb.py, and write next to themselves.
    parts.json gains U11 and C40 (both low SMD parts south of the OLED). The
    fit report is unchanged and the tray and cap STLs come out byte-identical
    to the rev7 case: a printed rev7 case fits rev7.1.
    Outputs renamed: ninepin-ux-case-cap.stl, ninepin-ux-case-tray.stl,
    ninepin-ux-case.step, ninepin-ux-case.FCStd.
    [amigahid-pico-rev7-case.FCStd, ninepin-ux-case-cap.stl, ninepin-ux-case-tray.stl, ninepin-ux-case.FCStd, ninepin-ux-case.step]
2026-11-10 doc: Ninepin UX docs, licences
    - README: what the board is, features, docs, repository layout, credits
    - doc/user-guide.md (was rev7-guide.md): connecting per Amiga model,
    first install from Releases, modes, menu, pads, Bluetooth, Wi-Fi,
    network control, updates, console
    - doc/board.md (was ux-rev7.md): connectors, power, encoder, OLED; rev7.1
    - doc/build.md (was installation.md): firmware build from firmware/,
    options, ordering at JLCPCB, hand-fitted parts, the case
    - doc/errata.md: rev7 and rev7.1 only
    - doc/history.md: earlier boards, the tags holding them and the firmware
    targets that build for them; replaces ux-rev1.md, hardware.md and the
    upstream errata
    LICENSE is the EPL-2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
    [rev7.1-mouser-hand-10.csv]
2026-11-10 ci: rev7 firmware on master, releases from fw-v* tags
    Builds the Bluetooth, no-Bluetooth and SH1106 variants of the rev7
    image on pushes to master, pull requests and by hand; the old board
    targets and branches are gone. Artifacts are ninepin-ux-<variant>-<id>.
    A pushed fw-v* tag also creates the GitHub Release for it, with the
    Bluetooth build as ninepin-ux.uf2 and partition-table.uf2.
2026-11-11 rev7.1: full-assembly BOM/CPL beside the SMT-only pair, Mouser BOM per board
    make_fab.py writes both recipes every run: ninepin-ux-rev7.1-{bom,cpl}.csv (SMT-only, Economic
    PCBA, unchanged) and ninepin-ux-rev7.1-full-{bom,cpl}.csv (every part, Standard PCBA with THT).
    --full is gone. The gerbers carry KiCad's export date, so the zip is now only cut again when the
    board changed since the manifest was written (or with --regen); the committed zip stays
    byte-identical. check_rev7_1_fab.py F6/F7 require the full pair.
    The Mouser hand-fit import is now for one board (rev7.1-mouser-hand.csv); the buyer sets the
    quantity in the cart. build.md: both assembly options, the RM2 preview-model note.
    Boar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
    [ninepin-ux-rev7.1-full-bom.csv, rev7.1-mouser-hand-10.csv, rev7.1-mouser-hand.csv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]
2026-11-12 doc: OLED posts, female-female or male-female with the thread cut to 5 mm
    11 mm M2 nylon posts with M2 x 5 nylon screws. The usual male-female post's 6 mm thread sticks out
    4.4 mm under the board, and the case floor is 4.0 mm below it.
2026-11-12 rev7.1 fab: SMD parts placed at their body centre, fixes U9 (RM2) 2.85 mm off
    The CPL used the centre of the copper pads for every part, which is right for the THT parts
    (their KiCad origin is pin 1) but not for the RM2: it has no castellations on its antenna end,
    so its pad centre sits 2.85 mm from the body centre JLC places by. Pure SMD footprints now use
    their origin. Only the U9 row changes (X 11.40 -> 8.55 mm); every other SMD part has its pads
    centred on its origin. Board, BOMs and gerbers unchanged; fab check 7/7.
    [ninepin-ux-rev7.1-cpl.csv, ninepin-ux-rev7.1-full-cpl.csv]
2026-11-12 rev7.1 bom: full Mouser BOM, encoder in both Mouser files
    rev7.1-mouser-full.csv: every board part from Mouser for one board, built from the rev7 file
    (tag hw/ux-rev7) with the rev7.1 changes: U11 TLV803SDBZR, C40 on the 100 nF 0402 line, R70/R71
    on the 27R 0603 line with R57/R58. LED1 is not at Mouser. Both Mouser files gain the optional
    Bourns PEC11R-4215F-S0024 encoder. All 51 lines in stock for 10 boards on 2026-11-12 (thin: U11
    14, the 1k Walsin 56).
    [rev7.1-mouser-full.csv, rev7.1-mouser-hand.csv]
2026-11-12 case: BOOT/RESET holes 0.3 mm higher, on the actuator centre
    The PTS645Vx58 actuator spans 1.93-5.07 mm above the board top (KiCad
    model), centre 3.5 mm; the holes were cut at 3.2, so the buttons sat high
    in them on the printed case. SW_STEM_Z = 3.5 now drives the hole, the lip
    notch and the fit-check stem.
    [ninepin-ux-case-cap.stl, ninepin-ux-case-tray.stl, ninepin-ux-case.FCStd, ninepin-ux-case.step]
2026-11-13 case: lid logo and wall labels as two-colour inlays
    Lid: nine dots in the DE9 layout and a dot-matrix NINEPIN UX, cut 0.6 mm
    into the lid, with the matching body as ninepin-ux-case-cap-logo.stl.
    Wall labels 2.5 -> 3.5 mm so their strokes print with a 0.5 mm nozzle,
    matching bodies in ninepin-ux-case-tray-labels.stl. The STEP carries all
    four bodies. Printed in one colour both stay debossed.
    [ninepin-ux-case-cap-logo.stl, ninepin-ux-case-cap.stl, ninepin-ux-case-tray-labels.stl, ninepin-ux-case-tray.stl, ninepin-ux-case.FCStd, ninepin-ux-case.step]
2026-11-13 case: labels HOST, USB-C and RST
    The computer-side mini-DIN is HOST (the firmware decides which machine),
    the USB-C is no longer only a 5 V input, RESET is RST. BOOT sits 3.5 mm
    off its button so USB-C fits between the two; the build now fails when
    two wall labels come closer than 1.5 mm.
    [ninepin-ux-case-tray-labels.stl, ninepin-ux-case-tray.stl, ninepin-ux-case.FCStd, ninepin-ux-case.step]
2026-11-13 firmware: page log-in form, settable page password, pad combos, device name
    Page (join mode):
    - a log-in form with a session cookie instead of the browser's basic
    auth prompt, so password managers work; basic auth still accepted
    for scripts. Sessions, the password check and the lockout move to
    web_auth.c, shared with the network-control api.
    - the page password can be changed on the page (8-16 characters) and
    switched off (page_open; also in the menu). Without it a firmware
    update always waits for a BOOT press. "New page password" in the
    menu switches it back on.
    - device name: replaces ninepin-xxxx as the access point's name and
    the .local address.
    Pads:
    - six combo slots, se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
    [http_server.c, http_server.h, input_bridge_bt.h, kvmd_api.c, menu.c, ota.c, pads.c]
2026-11-13 firmware: named pad profiles, flash map
    A pad profile keeps the pad combos, Pad directions and Triangle button
    under a name: 16 slots, names up to 12 characters. A profile is a copy;
    loading one writes it into the settings, and settings pad_profile
    remembers which one (the page and menu mark it changed when the
    settings no longer match).
    - profiles.c: the table in one record (magic, sequence, crc) in two
    sectors written in turn, directly below the settings.
    - flash_map.h: who owns which sector above the firmware slots; the
    settings take their offset from it (unchanged).
    - page: Save as profile (stores the form and the profile), Load, Delete,
    as formaction buttons of the settings form;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
    [flash_map.h, http_server.c, http_server.h, main.c, menu.c, profiles.c]
2026-11-13 firmware: mouse diag on one OLED line, in USB mode too
    The wheel readout was written to a fifth line the OLED does not have, and
    the movement line was only drawn on the Amiga path. One line now carries
    movement, buttons, the last wheel step and a count of wheel reports, in
    every output mode.
2026-11-13 firmware: display setting takes effect at once
    Changing Display redraws the status screen and puts the chosen readout
    over its line straight away; the hid readout is kept from the last plug
    event, so turning it on no longer waits for a replug or a reboot. Leaving
    a diagnostics mode brings the status text back.
    [debug_cons.c]
2026-11-13 firmware: page fits a phone screen
    The combo table takes the width it is given (fixed layout, fields fill
    their columns), fieldsets may shrink below their content, and label rows
    wrap.
    [web_page.c]
2026-11-13 firmware: two-level menu, profile switch from the pad, folding page groups
    The OLED menu keeps mode, pad profile and the ports on its top level and
    puts the rest behind six groups; leave goes up a level, and the menu
    reopens at the setting visited last. PS with d-pad left / right steps
    through the saved pad profiles (and none), shown on the display for 3 s.
    The page's groups are details boxes; mode, the current ports, pads and
    combos start open.
2026-11-13 firmware: pair a second Bluetooth pad with one connected
    With a classic pad connected the board never searched for another, so a
    second pad could not be paired. A pairing window (BT pair) now searches
    regardless.
2026-11-13 firmware: Pair button on the page, 30 s search after a pad connects
    The page's Bluetooth group opens the 2 minute pairing window, as BT pair
    does in the menu. After a classic pad connects the board goes on
    searching for 30 s, so a second pad can be paired straight after the
    first without the window.
2026-11-13 firmware: the 30 s pad search survives the connect
    The search was armed just before the connect path stopped the inquiry,
    which also removed its timer. Arm it after the stop.
2026-11-13 firmware: 32 pad profiles, each for a machine, one remembered per mode
    A profile carries the machine it is for (Amiga, C64 or any) and is
    offered in that mode only. Each mode remembers the profile it had last;
    a change of mode brings it back. The 16-slot record of the previous
    firmware is read and carried over as profiles for any machine.
2026-11-13 firmware: uptime and the reason for the last restart
    A hard fault and the stage the main loop had reached are kept in the
    watchdog scratch registers and read back at the next start. The page's
    Status and the console's info show how long the board has run and what
    started it: power on, reset, brown-out, a requested restart, the
    watchdog (with the stage) or a fault (pc, lr, cfsr).
    [console_cmd.c, main.c, reset_info.c, reset_info.h, web_page.c]
2026-11-13 firmware: a fast mouse with Display = mouse diag ran the heap out
    Every display write queues the whole frame on the heap, and the mouse
    readout wrote once per report: a fast mouse filled the heap, malloc
    panicked and the board restarted. Redraws past 16 waiting transactions
    are now only noted and one frame goes out when the queue has drained
    (disp_task); the mouse readout draws at most 20 times a second.
    Found with the restart record, which now also keeps a panic's message
    and the return addresses on the stack (shown as Last fault), and says
    'restart asked for' after an update.
2026-11-13 firmware: Updates need BOOT is settable on the page
    The setting sits in the page's Board group with a warning, and no longer
    turns itself on when the page password is off: whether a firmware update
    needs a press on the board is the owner's choice.
    [http_server.c, ota.c, web_page.c, wifi.c]
2026-11-13 firmware: the 1351 mouse moves, at a usable speed
    The pot program reloaded its hold time from a register the hold loop had
    counted down, so after the first value it held the line low for an hour
    and the C64 read one constant. The value is now kept in y.
    Mouse counts are scaled down by the mouse speed setting (12, 8, 6, 4 per
    step) and paid out one counter step a millisecond, so the 6-bit counters
    never turn more than half way between two reads.
2026-11-13 firmware: every page group has its own Save and comes back to it
    A save answers 303 to /?saved=<group>#<group>: the page returns at the
    group the button was in, with that group open and a line there saying
    how the save went. Profile save, load and delete do the same for the
    combos group; whilst the main loop is still at it the page is asked for
    again.
2026-11-13 firmware: check for a release and install it from the page and the menu
    The page's Firmware update section and Board > Check for update look for
    the latest release and install it: straight away when it is newer, only
    on purpose when it is older or this firmware is no release. The page
    waits for the look to finish and comes back to the section. A firmware
    that starts and finds another one was being restarted into says that it
    fell back.
2026-11-14 firmware: the watchdog stays on after an update
    A firmware that accepted itself after an update ran without the watchdog
    until its next restart: accepting disables it and apply_watchdog() saw
    no change to make. It is armed again after the accept.
    With the watchdog at 2 s a check for a release restarted the board, the
    tls handshake keeps the main loop away for longer than that. Whilst the
    board talks to the release server the watchdog has 8 s, and the p-256
    maths use the faster reduction.
    A release that fell back was not reported: the new firmware cleared the
    note when it started. It now keeps it until it is accepted.
    Status shows where the main loop stands when it has stopped.
